2063F/RISC_V_fpga/src/alu.v

// =============================================================================
// alu.v - 32-bit ALU for RISC-V RV32IM CPU
// =============================================================================
// Operations: ADD, SUB, AND, OR, XOR, SLL, SRL, SRA, SLT, SLTU.
// The RV32M multiply and divide live in multiplier.v and divider.v, which are
// multi-cycle; this module stays purely combinational.
//
// Key differences from x86 ALU:
//   - No flag registers (CF, ZF, SF, OF, PF, AF) — not needed!
//   - Always 32-bit — no 8/16/32-bit size switching
//   - Only a 'zero' output (rv_core's branches compare rs1/rs2 directly)
//   - Much simpler: ~100 lines vs 357 lines for x86
// =============================================================================

`include "riscv_defines.vh"

module alu (
    input  wire [31:0] a,        // Operand A (always from register)
    input  wire [31:0] b,        // Operand B (register or immediate)
    input  wire [4:0]  alu_op,   // Operation select (see riscv_defines.vh)

    output reg  [31:0] result,   // Operation result
    output wire        zero      // 1 when result == 0
);

    // zero flag: kept for tb_alu; the CPU's branches use control_unit's comparator
    assign zero = (result == 32'd0);

    always @(*) begin
        case (alu_op)
            // ------------------------------------------------------------------
            // ADD: a + b
            // ------------------------------------------------------------------
            `ALU_ADD:    result = a + b;

            // ------------------------------------------------------------------
            // SUB: a - b
            // ------------------------------------------------------------------
            `ALU_SUB:    result = a - b;

            // ------------------------------------------------------------------
            // AND: a & b
            // ------------------------------------------------------------------
            `ALU_AND:    result = a & b;

            // ------------------------------------------------------------------
            // OR: a | b
            // ------------------------------------------------------------------
            `ALU_OR:     result = a | b;

            // ------------------------------------------------------------------
            // XOR: a ^ b
            // ------------------------------------------------------------------
            `ALU_XOR:    result = a ^ b;

            // ------------------------------------------------------------------
            // SLL: Shift Left Logical — shift amount = b[4:0]
            // ------------------------------------------------------------------
            `ALU_SLL:    result = a << b[4:0];

            // ------------------------------------------------------------------
            // SRL: Shift Right Logical — shift amount = b[4:0]
            // ------------------------------------------------------------------
            `ALU_SRL:    result = a >> b[4:0];

            // ------------------------------------------------------------------
            // SRA: Shift Right Arithmetic (sign-extending) — shift = b[4:0]
            // ------------------------------------------------------------------
            `ALU_SRA:    result = $signed(a) >>> b[4:0];

            // ------------------------------------------------------------------
            // SLT: Set Less Than (signed comparison)
            //      result = 1 if a < b (signed), else 0
            // ------------------------------------------------------------------
            `ALU_SLT:    result = ($signed(a) < $signed(b)) ? 32'd1 : 32'd0;

            // ------------------------------------------------------------------
            // SLTU: Set Less Than Unsigned
            //       result = 1 if a < b (unsigned), else 0
            // ------------------------------------------------------------------
            `ALU_SLTU:   result = (a < b) ? 32'd1 : 32'd0;

            // ------------------------------------------------------------------
            // PASS_B: Pass operand B through unchanged
            //         Used for LUI: rd = imm (no addition needed)
            // ------------------------------------------------------------------
            `ALU_PASS_B: result = b;

            // ------------------------------------------------------------------
            // M Extension: Multiply and Divide
            // ------------------------------------------------------------------
            // Neither is handled here any more; both were combinational and
            // both took a turn as the critical path of the design. The divider
            // held it down to 5.031 MHz, and once that moved out the 32x32->64
            // multiply carry chain held it at 39.377 MHz - against a 50 MHz
            // constraint in both cases. multiplier.v and divider.v now run them
            // over a few cycles with the CPU stalled, and their results are
            // muxed in at write-back, so these opcodes fall through to the
            // default below.

            default:     result = 32'd0;
        endcase
    end

endmodule
