2063F/RISC_V_fpga/src/usb_hid_host/usb_hid_host_rom.v

module usb_hid_host_rom(clk, adr, data);
    input clk;
    input [13:0] adr;
    output [3:0] data;
    reg [3:0] data; 
    reg [3:0] mem [0:535];
    initial $readmemh("src/usb_hid_host/usb_hid_host_rom.hex", mem);  // path relative to the repo root (build.tcl stages it for Gowin)
    always @(posedge clk) data <= mem[adr];
endmodule
