2063F/RISC_V_fpga/examples/othello_embedded/othello.c

#include "othello.h"
#include "uart.h"

/* d4=index(row3,col3)=27(白) e4=index(row3,col4)=28(黒)
   d5=index(row4,col3)=35(黒) e5=index(row4,col4)=36(白) */
const Bitboard INIT_BLACK = (1ULL << 28) | (1ULL << 35);
const Bitboard INIT_WHITE = (1ULL << 27) | (1ULL << 36);

#define FILE_A 0x0101010101010101ULL
#define FILE_H 0x8080808080808080ULL
#define NOT_A  (~FILE_A)
#define NOT_H  (~FILE_H)

static const int DIRS[8] = {8, -8, 1, -1, 9, 7, -7, -9};

Bitboard shift_dir(Bitboard bb, int d) {
    /* 列方向にまたがる手（東方向成分を含む: +1,+9,-7）はH列がラップしないよう
       あらかじめH列を落としておく。西方向成分(-1,+7,-9)はA列を落とす。 */
    if (d == 1 || d == 9 || d == -7) {
        bb &= NOT_H;
    } else if (d == -1 || d == 7 || d == -9) {
        bb &= NOT_A;
    }
    if (d > 0) {
        return bb << d;
    } else {
        return bb >> (-d);
    }
}

Bitboard get_moves(Bitboard P, Bitboard O) {
    Bitboard empty = ~(P | O);
    Bitboard moves = 0;
    for (int i = 0; i < 8; i++) {
        int d = DIRS[i];
        Bitboard x = shift_dir(P, d) & O;
        for (int k = 0; k < 5; k++) {
            x |= shift_dir(x, d) & O;
        }
        moves |= shift_dir(x, d) & empty;
    }
    return moves;
}

void apply_move(Bitboard P, Bitboard O, int sq, Bitboard *newP, Bitboard *newO) {
    Bitboard mb = 1ULL << sq;
    Bitboard flips = 0;
    for (int i = 0; i < 8; i++) {
        int d = DIRS[i];
        Bitboard cur = shift_dir(mb, d);
        Bitboard ray = 0;
        while (cur & O) {
            ray |= cur;
            cur = shift_dir(cur, d);
        }
        if (cur & P) {
            flips |= ray;
        }
    }
    *newP = P | mb | flips;
    *newO = O & ~flips;
}

void square_to_str(int sq, char *out) {
    out[0] = (char)('a' + col_of(sq));
    out[1] = (char)('1' + row_of(sq));
    out[2] = '\0';
}

void print_board(Bitboard black, Bitboard white, Bitboard hints) {
    for (int r = 0; r < 8; r++) {
        printf("%d ", r + 1);
        for (int c = 0; c < 8; c++) {
            int sq = sq_of(c, r);
            Bitboard bit = 1ULL << sq;
            if (hints & bit) {
                /* 全角(UTF-8)の〇は端末上で2桁ぶんなので、後ろの空白は付けない */
                uart_print("\xE3\x80\x87"); /* U+3007 〇 */
                continue;
            }
            char ch = '.';
            if (black & bit) ch = 'R'; // shown red on the LED matrix
            else if (white & bit) ch = 'G'; // shown green on the LED matrix
            uart_putchar(ch);
            uart_putchar(' ');
        }
        uart_print("\n");
    }
    uart_print("  a b c d e f g h\n");
}
