2063F/RISC_V_fpga/(commit log)

2026-06-18 Phase6完成
2026-09-16 UART RX/board_io追加とRV32M拡張、リポジトリ生成物の整理
    UART受信・GPIOボードIOモジュールを追加しCPU統合、examples/toolsに
    新規サンプルとビルドスクリプトを追加。あわせて.gitignoreを新設し、
    重複していたimpl/ビルド出力と巨大な波形ダンプ(.vcd)、シミュレーション
    バイナリ(.out)をgit管理から除外してリポジトリ肥大化を解消。
    [device.cfg]
2026-09-16 gprj/INIT_FILEの絶対パス依存を解消し既定hexをloop55に修正
    riscv_cpu.gprjのソース参照を個人環境の絶対パスから相対パスに変更し、
    他環境でも開けるようにした。あわせて未登録だったsrc/uart_rx.vを
    FileListに追加(合成時にモジュール未定義となる欠落だった)。
    fpga_top.vのINIT_FILE既定値も絶対パスを廃し、README記載の既定値
    loop55.hexに合わせて修正(tb_fpga_top.vのテスト前提と一致)。
    gprj.userはビルドのローカル状態ファイルのためgit管理から除外。
    [fpga_top.v]
2026-09-16 tb_memory.vの待機サイクル不足を修正(2段パイプラインのレイテンシ考慮漏れ)
    cpu_top.vは命令をifid_instへラッチした翌サイクルでレジスタ書き戻しを
    行う2段パイプライン構成だが、tb_memoryの初期化フェーズはwait_cycles(4)
    のみで4命令目(ADDI x4)の書き戻し完了を待たずにチェックしていたため、
    x4=0のままFAILしていた(それに連動しSB storeも誤った値を書き込みFAIL)。
    wait_cycles(5)に修正し、全12アサーションがPASSすることを確認。
    CPU本体(cpu_top.v)側にバグはなく、テストベンチのタイミング前提のみの
    問題だった。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
    [tb_memory.v]
2026-09-16 未検証命令のCPU統合テスト追加、死んだコード削除、コメント修正
    デコーダには実装があるがCPU統合レベルでは未検証だったAUIPC・JALR・
    BNE/BGE/BLTU/BGEUをtb_branch_full.vで、RV32Mの残り6命令(MULH/MULHU/
    MULHSU/DIVU/REM/REMU)をtb_rv32m_full.vでカバー。BLTU/BGEUは符号あり
    比較と結果が食い違う値(-1 vs 1)を使い、符号なし比較の実装漏れを
    検出できるようにした。命令エンコードはPythonの簡易エンコーダで生成し
    手計算ミスを排除。
    その他:
    - data_memory.vのヘッダコメントを実装(16384語/64KB)に合わせて修正
    (128-word/512-byteという古い記述が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
    [data_memory.v, tb_branch_full.v, tb_rv32m_full.v]
2026-09-16 軽微な清掃: 使い捨てtclスクリプト・重複hex・elf2hex.pyの命名を整理
    - test_devices.tcl / test_syntax.tcl(Gowinデバイス品番の当たり調査用の
    使い捨てスクリプト)と生成物置き場test_dir/を削除。
    - ルート直下loop55.hex、src/loop55.hex、src/examples/(誤配置)、
    gowin_project/riscv_cpu/examples/・src/(誤って複製されたディレクトリ)
    配下のhexファイルを削除。いずれもどのビルド/テストベンチからも
    参照されていない孤立コピーだったことを事前にgrepで確認済み。
    - tools/elf2hex.pyをtools/bin2hex.pyに改名(実際はELFではなく
    objcopy後の生バイナリ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
2026-09-16 UART RXをfpga_topまで配線(実機でRXが未接続だった問題を修正)
    cpu_top の uart_rx_pin が fpga_top のどこにも接続されておらず、
    シミュレーションで z のまま、実機ではUART RXが機能していなかった。
    制約ファイル側の uart_rx (B3) もコメントアウトのままだった。
    - fpga_top に uart_rx ポートを追加し cpu_top.uart_rx_pin へ接続
    - tang_primer_25k.cst の uart_rx 制約を有効化
    - tb_fpga_top はアイドルHigh (1'b1) で接続
    [fpga_top.v, tb_fpga_top.v]
2026-09-16 Cビルドの圧縮命令混入とスタック非アラインを修正
    1. -march 未指定のため gcc 既定の rv32imac が選ばれ、本CPU(RV32IM)が
    未実装の圧縮命令(C拡張)を含むバイナリが生成されていた。デコーダは
    未定義オペコードを黙って読み飛ばすため、エラーも出さずCPUが暴走する。
    tb_uart_rx_cpu_c がタイムアウトしていた直接原因で、_start の bss
    クリア直後 (0x20 の c.addi) から先へ進めていなかった。
    -> README のビルド手順に -march=rv32im -mabi=ilp32 を明記し、
    examples の elf/bin/hex を再生成。16ビット命令ゼロを確認。
    2. __stack_top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
2026-09-16 シフト/論理/比較命令のCPU統合テスト追加、テストベンチのalu_op幅を修正
    SLLI/SRLI/SRAI/SLL/SRL/SRA/XOR(I)/OR(I)/AND(I)/SLT(I)/SLTU(IU) は
    ALU単体(tb_alu.v)とデコーダ単体(tb_decoder.v)でしか検証されておらず、
    cpu_top を通した実行経路が未検証だった。tb_shift_logic.v を追加して
    21項目を確認(全てパス、CPU側の不具合はなし)。shamt の b[4:0] マスクと
    x0 書き込み無視も併せて検証している。
    また tb_alu.v / tb_decoder.v / tb_lbu_check.v の alu_op が 4bit 宣言で、
    5bit のポートに対し幅不足だった。ALU_DIVU(16)〜ALU_REMU(18) は
    そもそも表現できずテスト不能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
    [tb_alu.v, tb_decoder.v, tb_lbu_check.v, tb_shift_logic.v]
2026-09-17 初期値つきグローバル変数を動くようにする(.dataのROM->RAMコピーを実装)
    link.ld は .data を 0x0001_0000 (RAM) に置いていたが、hex で初期化される
    のは ROM だけで、crt0 にもコピー処理がなかった。そのため初期値つきの
    グローバル変数は実行時に電源投入時のRAM内容のまま読み出されていた。
    さらに VMA=LMA=0x10000 のせいで objcopy -O binary が ROM と RAM の隙間
    64KB をゼロ埋めし、65540バイトの bin を吐いて 8192語のROMに収まらなかった。
    - link.ld: .data の LMA を .rodata の直後 (ROM内) に置き (AT)、
    _data_lma / _data_start / _data_end を公開
    - crt0.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
2026-09-17 riscv_defines.vh の重複コピー2つを削除
    riscv_defines.vh がリポジトリルート / src / sim の3箇所に同一内容で
    存在していた。iverilog はインクルード元ファイルのディレクトリを先に
    探すため sim/*.v は sim 側を、src/*.v は src 側を拾っており、片方だけ
    編集すると気付かないまま定義が食い違う状態だった。
    Gowin 側 (gprj) もルートの vh は参照しておらず、src/riscv_defines.vh
    だけが実際に使われていたため、これを唯一の定義元として残す。
    sim からは README 記載どおり iverilog -I src で解決される。
    全19本のテストベンチがコンパイル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
2026-09-17 install_riscv_toolchain.ps1 が動くツールチェーンを検出できない問題を修正
    このPCには xPack 版の riscv-none-elf-* が入って正常にビルドできるのに、
    スクリプトは riscv64-unknown-elf-* しか探しておらず「Not found」と報告
    していた。加えて導入に使っていた winget パッケージ RISC-V.CPP は存在せず
    (winget search riscv の結果もゼロ)、インストール処理は必ず失敗していた。
    さらにファイルが BOM なし UTF-8 だったため、Windows PowerShell 5.1 が
    日本語コメントを ANSI として誤デコードし、スクリプト自体がパースエラーで
    起動しなかった (Test-Pa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
2026-09-17 FPGA合成が実質CPU無しのビットストリームを吐いていた問題を修正
    gw_sh build.tcl を実行して初めて分かった不具合が2つある。どちらも
    合成は「成功」して .fs まで生成されるため、これまで気付けなかった。
    1. メモリ初期化ループが合成上限を超えていた
    GowinSynthesis は for ループを展開し 2000 回で打ち切ってエラーにする。
    instruction_memory の 8192 回 / data_memory の 16384 回の初期化ループが
    これに引っ掛かり、両モジュールが "remains a black box due to errors" と
    なって run syn が失敗していた。
    -> 初期化はシミュレーシ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
    [data_memory.v, instruction_memory.v]
2026-09-17 メモリをBSRAM化しロードを1サイクルストールさせる
    これまで両メモリは非同期読み出しかつバイト単位のビット選択書き込みで、
    BSRAM に載らずレジスタとして推論されていた。64KB の RAM は 524288 個の
    DFF となり、デバイス上限 23280 を大きく超えて合成が通らなかった。
    実機フローで切り分けた結果は以下のとおり:
    読み出し | 書き込み | 結果
    ---------|-----------|------------------------------------------
    非同期 | バイト単位 | IF0008 DFF 524288 個
    同期 | バイト単位 | IF0008 DFF 524288 個
    非同期 | ワード一括 | IF0008 DFF 524288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
2026-09-19 除算を多サイクル化してタイミング制約を満たす
    alu.v は RV32M の除算を32回反復の復元法で実装していたが、それを
    組み合わせ回路として完全に展開していた。出来上がるリップル連鎖は
    設計全体のクリティカルパスとなり、配置配線の結果は最大動作周波数
    5.031 MHz (50 MHz 制約に対しセットアップスラック -178.7ns) だった。
    CPU の他の部分は制約を余裕で満たしていた。
    - src/divider.v を新規追加。1クロックあたり商1ビットの復元法で、
    通常の除算は start から done まで34サイクル、ゼロ除算と
    MIN_INT/-1 のオーバーフロ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
2026-09-19 乗算を多サイクル化し、50MHz制約を満たすまで詰める
    除算を divider.v へ出した (ec7f24a) あと、loop55.hex での合成は
    53.997 MHz と出ていたが、これは誤った数字だった。loop55 は7命令しか
    使わないため、合成器が ROM の内容を定数として伝播させ、デコーダごと
    命令を削って CPU をそのプログラム専用に特殊化していた (乗算器が消え
    DSP が 0 になっていた)。
    現実的なプログラム (printf_demo.hex、467語、24種の命令) で測り直すと
    39.377 MHz、セットアップスラック -5.395ns で制約未達。クリティカルパスは
    alu_inst/mul_unsigned の桁上げ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
2026-09-19 3段パイプライン化してタイミングに実マージンを確保する
    2段構成 (フェッチ / デコード+レジスタ読み出し+実行+書き戻し) では、
    命令ROM -> レジスタファイルの32:1読み出しマルチプレクサ -> ALU が
    1サイクルに収まっており、これが乗除算を別ユニットに出した後の
    クリティカルパスだった。スラックは +0.001ns しかなく、実質ゼロマージン
    だった。
    レジスタ読み出しを ALU から切り離して3段にする:
    IF フェッチ : PC が命令ROMを駆動
    ID デコード : デコード、即値生成、レジスタファイル読み出し
    EX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
2026-09-19 READMEを3段パイプライン化後の実態に更新
    - 完成状況を3段パイプライン / 多サイクル乗除算 / BSRAM配置に書き換え
    - 合成の実測値 (周波数・リソース) を追記
    - ROM の定数伝播でプログラム特化が起きるため、素の値を見るときは
    命令種の多いプログラムで測る必要がある旨を注記
    - ロードマップの Phase 7 / 8 を完了に、以降を SDRAM / 割り込み / CSR に
    - ディレクトリ構成に multiplier.v / divider.v と新規テストベンチ3本を追加
2026-09-19 実機書き込み用スクリプト tools/program.ps1 を追加
    これまで書き込み手順が README に「Tang Primer 25K に書き込みます」と
    一行あるだけで、実際のコマンドがどこにも残っていなかった。
    tools/program.ps1:
    - programmer_cli.exe を PATH と C:\Gowin 配下から自動で探す
    - --scan でケーブルとデバイスを確認し、未接続なら何もせず終了する
    - 既定は SRAM 書き込み (揮発)。-Flash で外部SPIフラッシュ (永続)
    - -ScanOnly で検出確認だけ行う
    - ビットストリームより新しい src/*.v があれば警告する
    (合成し直さずに古いものを焼く事故を防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
2026-09-19 実機での動作確認を反映し、SRAM書き込みの既定からverifyを外す
    Tang Primer 25K で loop55 を SRAM に書き込み、LED[0] のハートビートと
    LED[1] 点灯 (CPU が x1 = 55 に到達) を実機で確認した。3段パイプライン、
    BSRAM 上の命令ROM/データRAM、フォワーディング、分岐が実機で噛み合って
    動作している。
    program.ps1 の既定を --run 4 (SRAM Program and Verify) から
    --run 2 (SRAM Program) に変更する。GW5A-25A では 4 を使うと書き込み自体は
    成功するのに読み戻しで
    Error: Verify failed of at 0
    User Code is: 0x0000D359
    Status Code is: 0x70026020
    となる。この系列は SR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
2026-09-19 UART受信スクリプトを追加し、実機でのUART動作確認を反映
    printf_demo.hex を Tang Primer 25K に書き込み、UART (COM3, 115200bps) から
    シミュレーションと同一の出力が得られることを確認した。
    === Phase 3: Minimal C Runtime & printf Demo ===
    [PASS] .bss section initialized to 0 successfully.
    Char: A
    String: Hello RISC-V!
    Integer: 12345 (neg: -9876)
    Hex: 0xdeadbeef (upper: 0xCAFEBABE)
    Entering Echo Test (Press key)...
    Received char: 'A' (0x41)
    Done!
    これで実機側で確認できたもの:
    - crt0 の .bss ゼロクリアと 64KB RAM への書き込み
    - ROM の .rodata を LBU で読む経路 (ポートB、ロード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
2026-09-19 uart_echo_c の実機動作確認を追記
    Tang Primer 25K で uart_echo_c.hex を動かし、起動メッセージとエコーループを
    確認した。
    Hello from C program with expanded memory!
    BSS cleared successfully!
    Entering echo loop...
    エコーは1文字ずつ10回すべて一致、20文字を15ms間隔で連続送信しても
    取りこぼしなく返った。uart_getchar() は UART_RX_STAT をポーリングしており、
    1文字あたり約87us (115200bps) に対し CPU は 50MHz で回っているため
    十分な余裕がある。
2026-09-19 uart_monitor.ps1 に対話モードと16進表示を追加
    打った文字をそのままボードへ送る -Interactive を追加した。Esc または
    Ctrl+] で終了する。受信バイトを16進でも表示する -ShowHex も追加。
    文字化けやボーレート違いの切り分けに使える。
    ポートが開けなかったときのメッセージも、他の端末ソフトが掴んでいる
    可能性を示すように変えた (TeraTerm を開いたまま実行すると
    "Access to the path 'COM3' is denied." になるため)。
    実機で -Send 'hi!' -ShowHex を実行し、68 69 21 が正しくエコーされることを
    確認済み。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
2026-09-26 オセロAIを RV32IM ソフトCPU 上で動かせるようにする
    - 共有ソースに OTHELLO_BAREMETAL を追加 (固定小数点評価・静的置換表・
    ノード数による思考時間の近似・libc 非依存)。PC 版の挙動は従来と同一
    - UART で対戦 / BESTMOVE プロトコルに応答する othello_fpga.c を追加
    - othello_gui.py に --serial オプションを追加し FPGA 上のエンジンと対戦可能に
    - Makefile に fpga ターゲット、CPU 統合テスト sim/tb_othello_fpga.v を追加
    Claude-Session: https://claude.ai/code/session_019NwM2jy3tdyougQH7SKwzR
2026-09-26 オセロAIを1手0.309秒の大会規定で戦えるよう高速化する
    - CPU に読み出し専用のサイクルカウンタ (MMIO 0x8000_0020) を追加し、
    思考時間をノード数の近似ではなく実時間で打ち切る
    - 合法手生成・反転を定数シフトに展開、評価関数の確定石/隣接計算を軽量化、
    popcount/ctz の自前実装、乗算ハッシュ、命令スケジューリング無効化
    - 残り深さ1の葉の二重評価を削除しβカット、残り深さ2の並べ替えを軽量化
    - 評価関数を使わない終盤完全読みソルバを追加 (持ち時間内に読み切れなければ
    通常探索の手を返す)。途中で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
2026-09-26 オセロAI FPGA 版のビルド中間生成物をリポジトリから外す
    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
2026-09-26 対局中の着手をキー1文字で入力できるようにする
    0-9, a-z, A-Z, ';', ':' の64文字を順に 1a, 2a, ..., 8a, 1b, ..., 8h の
    マスに対応させる。メニューの keys で対応表を表示し、'!' で対局を中断する。
    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
2026-09-26 自作キーボード用に 8x8 キースイッチマトリクスの走査回路を追加する
    - src/keypad_matrix.v: 行を1本ずつ Low (他は Hi-Z) にして列を読み、
    チャタリング除去した押下をイベントとして CPU に渡す
    - board_io に MMIO 0x8000_0028 (読み: イベント有無とキー番号、書き: 消費) を追加
    - オセロAI の対局中はキー番号 i を KEY_CHARS[i] と同じマスとして受け付ける
    - サイクルカウンタを 0x8000_0020 から 0x8000_0030 へ移動する。board_io の
    LED 制御レジスタと重なっており、button_led の LED 書き込みが効かなくなっていた
    - 単体テスト tb_keypad_matrix.v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
2026-09-26 2色ドットマトリクス LED (LTP-12188M-08) に盤面を表示する
    - src/led_matrix_bicolor.v: 行アノード・列カソード(赤/緑)の 8x8 LED を
    1行1msでダイナミック点灯する。行切り替え時は全消灯してゴーストを防ぐ。
    極性はパラメータで変更可 (既定: 行は PNP 経由で Low 点灯、列は Low 点灯)
    - MMIO 0x8000_0040-0x8000_004C にフレームバッファ (赤/緑 各64bit) を置く
    - オセロAI は白の石を赤、黒の石を緑で表示し、盤面が変わるたびに更新する
    - 単体テスト tb_led_matrix_bicolor.v を追加し、統合テストで LED 表示も確認する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
2026-09-26 ドットマトリクス LED の配線をデータシートに合わせて具体化する
    - LTP-12188M のピン接続表 (行アノード/列カソード赤緑) に基づき、
    LED ピン番号と FPGA 信号・ピンの対応表を README に追加
    - 順電圧・電流定格から列抵抗 68Ω、行 PNP (500mA 級)、ベース抵抗 680Ω を推奨
    - 列のピンは LED 1個分の電流を吸い込むため DRIVE=16 にする
    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
2026-09-26 ドットマトリクス LED とキーマトリクスの FPGA ピンを実配線に合わせる
    - LED: 列1緑/列1赤/行1/…/行8 = G11,D11,B11,C11,A11,E11,K11,L5,F5,G7,H8,H5,
    G10,D10,B10,C10,A10,E10,L11,K5,G5,G8,H7,J5
    - キーマトリクス: 行 = J11,F7,J8,L9,L10,L7,K7,H1、列 = J10,F6,K8,K9,K10,L8,J7,H2
    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
2026-10-01 Dock の USB-A ポートにつないだ USB キーボードで着手できるようにする
    - nand2mario/usb_hid_host (Apache-2.0) を src/usb_hid_host/ に取り込み、
    PLL (src/gowin/gowin_pll_usb.v) で作った 12MHz で動かす
    - src/usb_keyboard.v: 起動プロトコルのレポートを CPU 側へ受け渡し、
    JIS 配列の F1-F12, 1-BS, Q-[, A-], Z-右Shift, 左Alt, 無変換 を
    順に A1, A2, ..., H8 (番号 0-63) の押下イベントにする
    - board_io に MMIO 0x8000_002C (接続状態・イベント・マス番号) を追加
    - オセロAI の対局中は USB キーボードの押下でも着手する
    - build.tcl: ROM の hex を examples/ 以外に置くとコピ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
2026-10-01 合成用の既定 ROM をオセロAI にし、USB コアを Verilog-2001 で通るようにする
    - fpga_top の INIT_FILE 既定値を othello_fpga.hex にする (手で書き換えずに
    そのまま合成できるように)。tb_fpga_top は loop55.hex を明示する
    - usb_hid_host.v の SystemVerilog 形式の配列サイズ [7] / [8] を
    [0:6] / [0:7] に書き換える (Gowin の既定の Verilog-2001 モードで合成するため)
    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
2026-10-01 usb_hid_host の取り込み時の変更点を README に追記
    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
2026-10-14 1手1分以内の規定に合わせ、FPGA版オセロAIの思考時間を高速化前の3秒に戻す
    - 対局モード (othello_fpga.c) と GUI の FPGA 設定の持ち時間を 250ms -> 3000ms
    - 高速化 (約17倍) はそのまま残すので、高速化前の3秒より深く読む
    (初期局面で深さ9、残り12マス以下は確実に読み切り、14マスは読み切れることがある)
    - 完全読みの閾値は計測の結果 14 のまま (16マスは3秒では読み切れない)
    - othello_fpga.hex を再生成し、README_FPGA.md の持ち時間・強さの記述を更新
    Claude-Session: https://claude.ai/code/session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
2026-10-14 FPGA版オセロAIの思考時間を50秒に延ばす
    - 対局モード (othello_fpga.c) と GUI の FPGA 設定の持ち時間を 3000ms -> 50000ms
    (1手1分以内の規定に、通信と PC 側の遅延の余裕を10秒持たせた値)
    - サイクルカウンタは符号なし32bitで上限80秒に丸めているので50秒はそのまま使える
    - othello_fpga.hex を再生成し、README_FPGA.md の持ち時間の記述を更新
    Claude-Session: https://claude.ai/code/session_018JFxc6239KQ3nF59qeEnXS
2026-10-14 思考時間50秒に合わせて完全読みの閾値を残り18マスに上げる
    50秒の持ち時間では残り16・18マスともに計測した4局面中3局面を時間内に
    読み切れた (16マス約12〜19秒、18マス約20〜38秒)。20マスは読み切れない。
    README_FPGA.md の強さの記述を50秒での実測値に更新。
    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
2026-10-17 READMEの古い記述を現状に合わせて更新
    - プロジェクト名の表記ゆれ (RISK_V -> RISC_V) を修正
    - ISA を RV32IM・実装済み45命令・未実装命令の扱いに更新
    - ディレクトリ構成を実ファイルに合わせて書き直し
    - ツールチェーン未導入前提の古い手順を削除し、全テストベンチの一括実行方法を追加
    - ビルド手順のサンプルに uart_echo_c / printf_demo を追記
    - 見出し番号の欠番 (6 -> 8) を修正
    Claude-Session: https://claude.ai/code/session_01Y24gsS8pMSdEPR9NdCK7an
2026-10-17 コード中の古いコメントを現状の設計に合わせて更新
    - fpga_top / control_unit の「single-cycle」記述を3段パイプライン前提に修正
    - fpga_top: INIT_FILE による読み込み、LED[0] の点滅周期 (~1.5Hz)、
    LED[1] の MMIO 点灯条件を実装どおりに記述
    - instruction_decoder: AUIPC の「For now」コメントを実装 (PC + imm) に合わせ、
    未対応オペコードが例外なしの no-op になることを明記
    - instruction_memory: 命令が現れるステージを EX から ID に修正
    - 各ファイルのプロジェクト名を RV32IM に統一、RISK-V の表記ゆれを修正
    - tb_branch_full: リポジトリに存在しな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
2026-10-17 マシンモードの CSR・例外・割り込みを実装
    CPU
    - Zicsr (CSRRW/S/C と即値形) と MRET を実装。FENCE / FENCE.I / WFI は NOP
    - csr_file.v: mstatus, misa, mie, mip, mtvec (direct/vectored), mscratch,
    mepc, mcause, mtval, mcycle/minstret (64bit), cycle/time/instret, ID 系 CSR
    - 例外: 命令アドレス非整列, 命令アクセスフォールト (ROM 外フェッチ),
    不正命令 (未定義エンコーディング・未実装 CSR・読み出し専用 CSR への書き込み),
    EBREAK, ロード/ストア非整列, ECALL
    - 割り込み: マシンタイマ / ソフトウェア / 外部 (UART 受信)
    - timer.v: mtime / mtimecmp / msip の MMIO (0x8000_0100-)。mtime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
2026-10-17 ロードデータ選択と ALU オペランド選択をレジスタ化してタイミングを改善
    Gowin のタイミング解析 (スラック +0.181ns) で、ワーストパスは
    ALU 加算 -> 32bit アドレス比較 -> ロードデータ選択 -> reg_write_data だった。
    - ロードは 2 サイクル目にデータを使い、その間 EX は停止しているので、
    アドレス領域の判定 (imem/dmem/UART/timer) と下位 2bit を 1 サイクル目に
    レジスタへ取り、ロードデータ選択はそのレジスタだけで行う
    - data_memory: サイズ/符号拡張に使うオフセットと有効ビットをデータと一緒に
    レジスタ化 (addr = ALU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
2026-10-17 CSR の書き込み許可をトラップ判定から切り離す
    トラップや mret で書き換えない CSR (mie, mtvec, mscratch, mcycle,
    minstret) は、CSR 命令の書き込み許可だけで更新するようにした。
    これまではトラップ判定 (分岐比較の結果に依存) の後段に書き込み許可が
    あり、Gowin のタイミングでワーストパスになっていた。cpu_top は
    トラップと CSR 書き込みを同時に出さないので動作は変わらない。
    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
2026-10-17 VGA関係及びキーボード関係
2026-10-17 VGA・LEDマトリクス・USBキーボードのソースを追加
2026-10-17 VGA 描画にパイプラインレジスタを追加してタイミングを改善
    セル位置の計算 (比較チェーン + 乗算) と石の円判定 (乗算) が 1 クロックに
    収まらずスラックが 0.008 ns しかなかったため、間にレジスタを 1 段入れた。
    走査カウンタは pix_en ごと (2 クロックに 1 回) にしか進まないので、
    出力が読み込まれる時点でレジスタの値は現在の画素と一致しており、
    表示位置はずれない。変更前の回路と 2 フレーム分の出力が全クロックで
    一致することを確認済み。
    Claude-Session: https://cla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
2026-10-17 失敗していたテスト 3 本を修正
    - tb_board_io: board_io の読み出しはレジスタ化されて 1 クロック後に
    出るので、キーボード列と LED ビットマップの読み出しで 1 クロック待つ
    - tb_fpga_top: loop55.hex が loop55.c からビルドし直され、x1 = 55 に
    ならなくなっていた。正式なソースの loop55.S から作り直した (以前の
    hex/bin と完全一致)。README の手順も .S からのビルドに直した
    - tb_trap_demo_c: trap_demo を 32KB RAM の link.ld でビルドし直した
    (スタック先頭 0x18000)
    あわせて README と cpu_top のコメントに残っていた「RAM 64KB」を
    32KB に直し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
2026-10-17 外部バスの書き込み許可からアドレス判定を外し、配置配線をタイミング優先にする
    - cpu_top: mem_write_en / mem_read_en を内部 RAM・UART・タイマの判定で
    絞るのをやめ、すべてのストア / ロードで立てるようにした。外部の
    board_io は自分のアドレスを 32 ビット全体で比較しているので動作は
    変わらない。CPU 側の判定と board_io 側の判定が直列に並んでいたのを
    解消し、LED ビットマップなどの書き込み許可の経路を短くする
    - build.tcl: place_option / route_option をタイミング優先 (1) にし、
    replicate_resources を有効にした。遅延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
2026-10-17 build.tcl: 配置配線オプションを 1 つのスイッチにまとめ、既定を 0 に戻す
    place_option / route_option / replicate_resources を pnr_timing_driven
    でまとめて切り替えられるようにした。1 にした合成で CPU の分岐 →
    フラッシュ経路が前回より約 2 ns 悪化したため、比較が済むまでは
    ツール既定 (0) にしておく。
    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
2026-10-17 分岐判定を ALU から切り離し、専用の比較器で行う
    control_unit は ALU の結果 (引き算の 0 判定、SLT/SLTU の結果) で
    分岐の成否を決めていたため、ALU の機能選択と 32 ビットの 0 判定が
    分岐判定 → 次 PC 選択 / フラッシュ / トラップ判定の経路に入っていた。
    rs1 / rs2 (ID でフォワーディング済み) を直接比較する比較器に置き換え、
    Gowin のタイミングで最悪だった 2 経路を短くする。
    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
2026-10-17 USB キーボードの pop をレジスタ化し、ストアアドレスから pending 更新への経路を切る
    board_io の usbkey_pop は CPU のアドレス加算器から usb_keyboard の
    64bit pending 更新へ組み合わせで直結しており、クリティカルパスだった。
    pop を 1 段レジスタに入れ、pop が届くまでの 1 クロックに読み出した
    場合は消費中のイベントを見せないよう valid ビットを 0 にする。
    tb_board_io に pop のタイミングと直後の読み出しのテストを追加。
    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
2026-10-28 CPU をハート (rv_core) と SoC (cpu_top) に分割しデータバスにハンドシェイクを導入
    マルチコア化の第一段階。
    - src/rv_core.v: 3段パイプライン・乗除算器・CSR を持つハート 1 個分。
    メモリと周辺は持たず、命令フェッチポートとデータバス
    (dbus_req / dbus_gnt / dbus_rvalid) だけで外とつながる。
    ロード・ストアは受け付けとデータを待って何サイクルでもストールできる。
    - src/cpu_top.v: SoC。ハート・命令ROM・データRAM・UART・タイマと
    アドレスデコードを持つ。ポートは従来と同じ。単一マスタなので
    dbus_gnt = 1、dbus_rvalid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
2026-10-28 mhartid のパラメータ化とタイマ (CLINT) のハート別ブロック化
    マルチコア化の第二段階。
    - rv_core / csr_file に HART_ID パラメータを追加し、mhartid がその値を返す。
    - timer.v に NUM_HARTS (最大 8) を追加。ハート h ごとに
    0x8000_0100 + 0x20*h のブロックを持ち、msip と mtimecmp をハート別に保持する。
    mtime は共通で、どのブロックからも読み書きできる。ハート 0 のブロックは
    従来のアドレスのままなので既存バイナリはそのまま動く。
    - csr.h にハート別のアドレスマクロと send_ipi() / timer_set_cmp_of() を追加。
    timer_set_cmp() は呼び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
2026-10-29 2 ハート構成: データバスのアービタ、ROM ポート共有、hart 1 起動制御
    マルチコア化の第三段階。
    - cpu_top に NUM_HARTS (1 / 2) を追加。2 ハートでデータバスを共有し、
    ラウンドロビンで調停する。ロードはデータを返すまでバスを占有する
    (スレーブがデータサイクルにもアドレスを使うため)。
    - hart 1 はリセットのまま待機し、hart 0 が 0x8000_0200 の bit1 を立てると
    起動する。命令 ROM のポート B は起動前は .rodata 読み出し、起動後は
    hart 1 のフェッチに使う (起動中は ROM からのデータ読み出しは 0)。
    hart 1 を起動し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
2026-10-29 A 拡張 (LR.W / SC.W / AMO*.W) を実装
    マルチコア化の第四段階。
    - ハートは LR / SC / AMO を「操作つきのロード」としてデータバスに 1 回だけ出し
    (dbus_amo / dbus_amo_op、オペランドは dbus_wdata)、SoC が読み出し・演算・
    書き込みをバスを占有したまま実行する。SC / AMO は旧値をいったんレジスタに
    取ってから書き込む 4 サイクル構成で、1 サイクルに読み出し・演算・書き込みを
    詰め込まない。
    - 予約はハートごとに 1 ワード。もう一方のハートが書き込むと消え、SC 実行で
    成否にかかわらず消える。
    - 非整列の LR はロー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
2026-10-29 README: 2 ハート構成と A 拡張の実機動作確認を反映
    multicore_demo.hex を Tang Primer 25K で実行し、ALL OK まで出力されることを
    確認した。ロードマップ Phase 11 を完了にし、実機確認済みの一覧と
    書き込み手順の期待動作に multicore_demo を追加。
    Claude-Session: https://claude.ai/code/session_01RnJZHGaCtFPcw9Ltzop4T8
2026-11-02 loop55: 最後に停止ループを追加し、実機で LED[1] が点灯しない問題を修正
    loop55.S は最後の nop の後に何もなく、実機では ROM の未使用領域が 0
    (不正命令) なので、不正命令例外で mtvec = 0 に飛んで最初から計算し直して
    いた。x1 = 55 になるのは一瞬だけで、LED[1] は約 12% のデューティで
    点滅し、消えているように見えていた。シミュレーションでは ROM の未使用
    領域が NOP で埋まるため再現しなかった (CSR・例外追加以降の問題)。
    j halt で止まるようにし、loop55.hex / .bin / .elf を作り直した。
    ROM の未使用領域を 0 にしたシ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
2026-11-07 2コア化
2026-11-07 バス調停をトラップ判定から切り離し、2 ハート構成の最遅経路を短縮
    2 ハート構成の実測 (othello.hex) で sys_clk の Fmax は 50.269 MHz、
    余裕 +0.107 ns だった。最遅経路は
    msip -> hart 0 の割り込み判定 -> 調停 (win1) -> バスのアドレス/データ選択
    -> タイマ・レジスタへの書き込み
    で、調停が各ハートの dbus_req (トラップ判定込み) を待っていたため。
    - rv_core に dbus_pend (トラップ判定前の dbus_req。レジスタのみから作る) を追加
    - cpu_top の調停 (win1) を dbus_pend で決め、実際のアクセスは勝者の dbus_req で
    行う。勝者がトラップし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
2026-11-07 実機確認用の一時変更を戻す (INIT_FILE を othello に戻し、誤って追加された「-」ファイルを削除)
    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
2026-11-09 Run riscv-arch-test 2.7.4 (I, M, privilege) in simulation
    sim/arch_test/run_arch_test.py builds each test with its own model_test.h
    and link.ld, runs it on a one-hart cpu_top and compares the signature with
    the reference. All 62 tests pass.
    - The branch tests and jal-01 are over 200 KB, so they are run in parts that
    fit the 32 KB ROM, each part checked against the reference. Three jal-01
    cases jump hundreds of KB and cannot run even alone.
    - The shipped references of the misaligned branch/jump tests assume the C
    extension; sim/arch_test/references/ holds the no-C ones, whose trap
    records were checked by hand.
    - arch_test.h's "la x0, ..." is rejected by current binutils; the script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
2026-11-09 Othello: search on both harts (YBW)
    Hart 0 walks the principal variation; at each PV node, once its first move
    is searched, the remaining moves are shared with hart 1, which runs
    search_hart_main() and takes moves with AMOADD. The best value is kept
    under an AMOSWAP spinlock. Ties at the root go to the earlier move, as in
    the one-hart search, so both pick the same move and score.
    - Levels 4 and 5 use both harts; new level 6 is Expert on hart 0 alone,
    for comparison. Each AI move prints its search time.
    - Built with link_mp.ld and 10 KB stacks per hart; the build line is in
    main.c and README.
    - search_check.c (host, hart 1 as a thread): 1800 positions at depths 2,
    4 and 5 give the same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
2026-11-09 Othello search: pause between polls in the wait loops
    A hart waiting for work (or for the other hart to finish) kept reading the
    shared job state, and every read takes the one data bus the two harts
    share, slowing the hart that is searching. The wait loops now run SPIN_PAUSE
    (64) nops, which use no bus, between reads.
    tb_othello_mp flushes each character so that the output is not lost if the
    run is cut short.
    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
2026-11-09 Othello: record the two-hart speed-up; bench at depth 2
    On the CPU (tb_othello_mp, depth 2, 3 positions) the search takes 8.24 M
    cycles on one hart and 5.13 M on two (x1.60); on the board a middle-game
    move took 1.217 s on one hart and 0.732 s on two. The polling pause saves
    1-3%: it also speeds up the one-hart search, which the idle hart 1 slowed.
    search_bench now defaults to depth 2, which Icarus runs in reasonable time.
    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
2026-11-09 tb_othello_mp: print bus statistics after each line
    For each hart, the number of accesses the bus took and the cycles a
    request spent waiting for it, to see how much the two harts get in each
    other's way.
    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
2026-11-09 C extension (compressed instructions)
    rvc_expand.v turns a 16-bit RV32C instruction into the 32-bit one it stands
    for before decode, so everything after the decoder is unchanged. It agrees
    with GNU objdump/as on all 49152 compressed encodings, except that C.MV
    expands to ADD (as the spec says) and reserved encodings are illegal.
    The fetch still reads one ROM word at a time. The IF stage now keeps the
    upper half of the last word, so that instructions may start on any
    halfword and 32-bit ones may straddle two words; a 32-bit instruction in
    the upper half right after a jump costs one cycle. Compressed JAL/JALR
    link to pc + 2, mepc keeps bit 1, misa shows C, and there is no longer an
    instructio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
2026-11-09 Timing: AMO from registers, branch off the ROM clock enable
    The critical path after the C extension (+0.101 ns) ran from the arbiter's
    mux select (win1) through the bus write data into the AMO adder and
    comparators, and on through wr_data to the write ports of the timer, RAM
    and board I/O. In the AMO's write step the mux only ever shows the owner's
    own request, so the operand, the operation and the SC flag are now
    registered when the request is accepted and the read-modify-write works
    from registers only.
    Also: a redirect no longer enables the instruction ROM. The word read in
    that cycle was thrown away anyway, and the new target is fetched in the
    next cycle, so this only takes the branch c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
2026-11-11 オセロ: 対局前に先手 (Red) / 後手 (Green) を選べるようにする
    - レベル選択の後に手番メニューを出す。キー1 / F1 = Red (先手)、
    キー2 / F2 = Green (後手、AI が先に打つ)。他のキーは現在の手番のまま。
    リセット後の既定は従来どおり Red
    - 合法手のヒント・手番表示・勝敗メッセージを選んだ側に合わせる
    - 勝敗の通算はどちらの色でも「あなた側の勝ち負け」で数える
    - othello.hex / .bin / .elf を再ビルド
    Verilator で cpu_top (2 ハート) + board_io を動かし、USB F1 でレベル1、
    マトリクスキー2で Green を選ぶと AI (Red) が先に打って G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
2026-11-11 Timing: board_io applies stores a clock late
    The critical path (+0.055 ns) ran from hart 1's address adder through the
    bus address mux and board_io's 32-bit address compares into the clock
    enables of the LED matrix registers. board_io now registers each store and
    decodes it a clock later, from registers.
    So that a load cannot read a board_io register before a store to it has
    landed, cpu_top accepts nothing in the clock after a store to anything but
    its RAM. Such stores are device writes and rare. Without that hold-off, a
    store to the LED bitmap followed by a load of it reads the old value; with
    it, the new one (checked on fpga_top).
    tb_board_io now looks for the effect of a store a clock l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
2026-11-12 Othello: two players, moving second, Black/White names
    A menu before every game: keys 1-6 play the AI at that level, 7 starts a
    two-player game, 8 switches between moving first and second against the
    AI, 9 switches the side names between Red / Green and Black / White (UART
    output only; Black always moves first). On a USB keyboard the number keys
    1-9 work as well as F1-F9. Results are kept for games against the AI only,
    counted from the player's side.
    sim/tb_othello_menu.v drives the menu and a few moves through a model of
    the key matrix and checks the UART output (being run).
    Claude-Session: https://claude.ai/code/session_01RnJZHGaCtF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
